NeXan87/Test-Bench/README.md

# Тестовый стенд для двигателей и клапанов на Arduino Nano




Универсальный тестовый стенд для проверки реле, двигателей, воздушных клапанов и другого промышленного оборудования с поддержкой ручного и автоматического режимов работы.

💾 Скачать [Руководство по эксплуатации](https://github.com/NeXan87/Test-Bench/blob/main/Manual.docx?raw=true)!<br/>
📷 Открыть [галерею с фото](https://github.com/NeXan87/Test-Bench/tree/main/Gallery).

## 🔧 Основные возможности

- **4 канала управления реле** (2 группы по 2 реле 24В и 2 пускателей 380В)
- **5 режимов работы**:
  - Ручной с взаимной блокировкой (переключатель реле)
  - Ручной независимый (реле управляются одновременно)
  - Испытание двигателя с тормозом (одновременное включение реле 24В и пускателя 380В)
  - Автоматический синхронный цикл
  - Автоматический асинхронный цикл
- **Гибкая настройка времён**:
  - Время включения реле: 1–60 сек
  - Задержка между циклами: 0–60 сек (с ограничениями по группам)
  - Количество циклов: 1–1000 или бесконечно
- **Защита и безопасность**:
  - Блокировка недопустимых комбинаций
  - Защита от одновременного включения в ручных режимах
  - Автоматическая остановка по завершению циклов
- **Расширенная индикация**:
  - 4 светодиода состояния
  - LCD 2004 дисплей с I2C интерфейсом
  - Отображение постоянного тока нагрузки
- **Удобное управление**:
  - 3 кнопки: Пуск 1, Пуск 2, Стоп
  - 2 переключателя для выбора режима и группы
- **Режимы калибровки и диагностики**:
  - Предназначены для тонкой настройки стенда

## 📐 Схема подключения

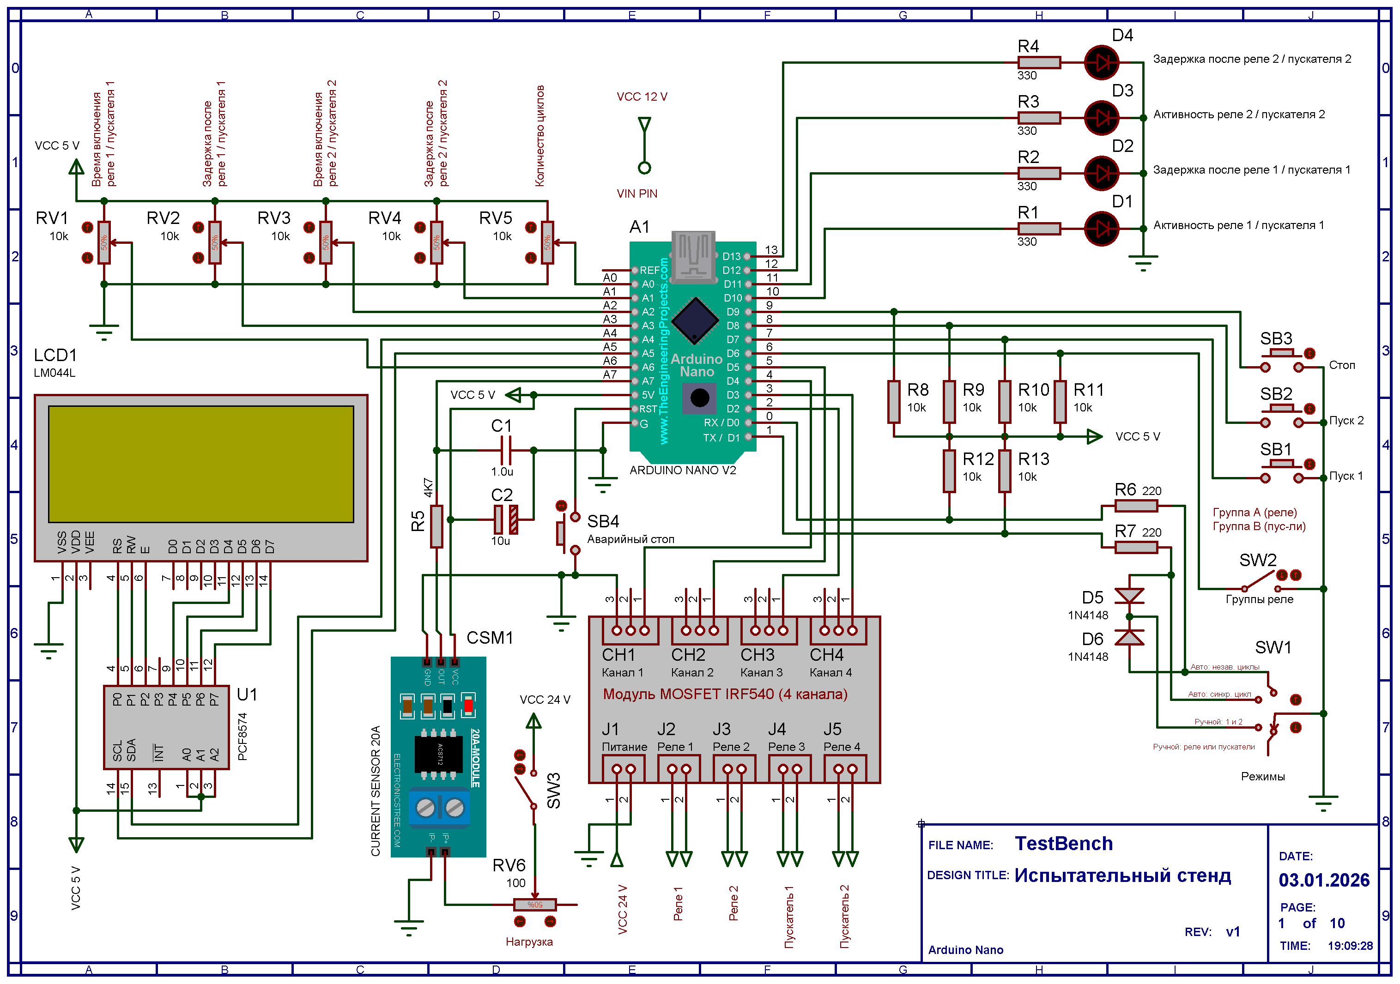
[picture p1: Electric Diagram/TestBench.png]
Принципиальная схема испытательного стенда на Arduino Nano


### Цифровые пины

| Пин | Компонент |
| --- | --- |
| D5  | Реле 24В 2 |
| D4  | Реле 24В 1 |
| D2  | Пускатель 380В 1 |
| D3  | Пускатель 380В 2 |
| D1  | Переключатель MODE0 |
| D0  | Переключатель MODE1 |
| D6  | Переключатель GROUP |
| D7  | Кнопка "Пуск 1" |
| D8  | Кнопка "Пуск 2" |
| D9  | Кнопка "Стоп" |
| D10 | Светодиод состояния реле 1 / пускателя 1 |
| D11 | Светодиод задержки после реле 1 / пускателя 1 |
| D12 | Светодиод состояния реле 2 / пускателя 2 |
| D13 | Светодиод задержки после реле 2 / пускателя 2 |

### Аналоговые пины

| Пин | Компонент |
| --- | --- |
| A0  | Потенциометр "Количество циклов" |
| A1  | Потенциометр "Задержка после реле 2 / пускателя 2" |
| A2  | Потенциометр "Время реле 2 / пускателя 2" |
| A3  | Потенциометр "Задержка после реле 1 / пускателя 1" |
| A6  | Потенциометр "Время реле 1 / пускателя 1" |
| A7  | Датчик тока ACS712 20A |

### I2C дисплей

| Дисплей | Arduino Nano |
| --- | --- |
| VCC | 5V |
| GND | GND |
| SDA | A4 |
| SCL | A5 |

## ⚙️ Режимы работы

### Выбор режима (переключатель D0/D1)

| D0 | D1 | Режим |
| ---- | ---- | --- |
| LOW  | LOW  | Ручной с взаимной блокировкой |
| HIGH | HIGH | Ручной независимый |
| HIGH | LOW  | Автоматический синхронный |
| LOW  | HIGH | Автоматический асинхронный |

### Выбор группы (переключатель D6)

- **LOW**: Группа A (реле 1=D4, реле 2=D5)
- **HIGH**: Группа B (пускатель 1=D2, пускатель 2=D3)

### Особенности режимов

- **Режим 1**: Взаимная блокировка реле (как реверсивный пускатель)
- **Режим 2**: Независимое управление реле, возможна одновременная работа
- **Режим 2, группа B**: Одновременное включение реле 24В и пускателя 380В для испытания эл. двигателя с тормозом
- **Режим 3**: Синхронный цикл: реле1 → задержка → реле2 → задержка → повтор
- **Режим 4**: Асинхронные циклы: каждое реле работает независимо по своим таймерам

### Ограничения

- Режим 4 **заблокирован для группы B** (мигание всех светодиодов)
- Для группы B минимальная задержка = 1 секунда
- Ограничение по превышению тока с выключением реле

## ⚙️ Конфигурационные константы

Все настройки проекта вынесены в файл `config.h` для удобства адаптации под различные требования.

### Пины подключения

| Константа | Значение по умолчанию | Описание |
| --- | --- | --- |
| `RELAY1_24V_PIN`, `RELAY2_24V_PIN`, `RELAY3_380V_PIN`, `RELAY4_380V_PIN` | `4, 5, 2, 3` | Пины управления реле и пускателей |
| `MODE0_SWITCH_PIN`, `MODE1_SWITCH_PIN` | `1, 0` | Пины переключателей режимов |
| `GROUP_SWITCH_PIN` | `6` | Пин переключателя группы |
| `START1_BUTTON_PIN`, `START2_BUTTON_PIN`, `STOP_BUTTON_PIN` | `7, 8, 9` | Пины кнопок управления |
| `LED_ON1_PIN`, `LED2_DELAY1_PIN`, `LED_ON2_PIN`, `LED4_DELAY2_PIN` | `10, 11, 12, 13` | Пины светодиодов индикации |
| `POT_ON1_PIN`, `POT_DELAY1_PIN`, `POT_ON2_PIN`, `POT_DELAY2_PIN`, `POT_CYCLES_PIN` | `A6, A3, A2, A1, A0`  | Аналоговые пины потенциометров |
| `CURRENT_SENSOR_PIN` | `A7` | Пин датчика тока (опционально) |
| `I2C_ADDR` | `0x27` | Адрес I2C дисплея |

### Временные параметры

| Константа | Значение по умолчанию | Описание |
| --- | --- | --- |
| `MIN_ON_RELAY1_TIME` | `1` | Минимальное время работы реле 1 (с) |
| `MAX_ON_RELAY1_TIME` | `60` | Максимальное время работы реле 1 (с) |
| `MIN_ON_RELAY2_TIME_SYNC`  | `0` | Минимальное время работы реле 2 в режиме Авто (3): синхронный (с) |
| `MIN_ON_RELAY2_TIME_ASYNC` | `1` | Минимальное время работы реле 2 в режиме Авто (4): асинхронный (с) |
| `MAX_ON_RELAY2_TIME` | `60` | Максимальное время работы реле 2 (с) |
| `MIN_DELAY_TIME_GROUP_A` | `0` | Минимальная задержка для группы A (с) |
| `MIN_DELAY_TIME_GROUP_B` | `1` | Минимальная задержка для группы для группы B и режима 4 (с) |
| `MAX_DELAY_TIME` | `60` | Максимальная задержка после реле и пускателей(с) |
| `DISPLAY_UPDATE_INTERVAL`  | `200` | Интервал обновления дисплея (мс) |
| `BLINK_LED_INTERVAL` | `500` | Интервал мигания при блокировке (мс) |
| `BRAKE_LED_INTERVAL` | `500` | Частота мигания светодиода в ожидании появления тока (мс) |
| `STARTUP_TIMEOUT` | `1500` | Длительность заставки при включении (мс) |
| `CURRENT_UPDATE_INTERVAL`  | `100` | Частота опроса датчика тока (мс) |
| `POT_UPDATE_INTERVAL` | `150` | Частота опроса потенциометров (мс) |
| `SHOW_SAVE_CALIB_TIMEOUT`  | `1500` | Время отображения сообщения о успешном сохранении данных калибровки потенциометров (мс) |
| `SHOW_ERROR_CALIB_TIMEOUT` | `2000` | Время отображения сообщения о ошибке позиции при калибровки потенциометров (мс) |

### Параметры циклов

| Константа | Значение по умолчанию | Описание |
| --- | --- | --- |
| `MIN_CYCLES` | `1` | Минимальное количество циклов |
| `MAX_CYCLES` | `1000` | Максимальное количество циклов |
| `MAX_CYCLE_COUNT` | `9999` | Максимум посчитанных циклов (далее не будет считать) |
| `INFINITY_THRESHOLD` | `1000` | Порог значения ADC для бесконечного режима |
| `CYCLE_CURVE_POWER`  | `1.5f` | > 1 — "ускоренная" шкала (больше значений в правой части) |
| `STEP1_MAX` | `10` | Границы ступеней: до 10 → шаг STEP1_SIZE |
| `STEP2_MAX` | `100` | Границы ступеней: 11–100 → шаг STEP2_SIZE |
| `STEP3_MAX` | `500` | Границы ступеней: 101–500 → шаг STEP3_SIZE |
| `STEP4_MAX` | `999` | Границы ступеней: 501–999 → шаг STEP4_SIZE |
| `STEP1_SIZE` | `1` | Шаг для изменения количества циклов потенциометром |
| `STEP2_SIZE` | `5` | Шаг для изменения количества циклов потенциометром |
| `STEP3_SIZE` | `10` | Шаг для изменения количества циклов потенциометром |
| `STEP4_SIZE` | `50` | Шаг для изменения количества циклов потенциометром |

### Потенциометры

| Константа | Значение по умолчанию | Описание |
| --- | --- | --- |
| `POT_ALPHA` | `0.3f` | Коэффициент обновления значений потенциометров. Чем меньше значение, тем быстрее |
| `POT_MIN_CALIB` | `200` | Минимальное значение АЦП при калибровке минимального положения потенциометров |
| `POT_MAX_CALIB` | `800` | Максимальное значение АЦП при калибровке минимального положения потенциометров |

### Датчик тока

| Константа | Значение по умолчанию | Описание |
| --- | --- | --- |
| `M_VPER_AMPERE` | `100.0f` | Коэффициент для ACS712-20A (измените для других моделей) |
| `OVERLOAD_CURRENT_LIMIT` | `5.1f` | Порог срабатывания защиты по превышению тока (А) |
| `OVERLOAD_TIME` | `3000` | Время удержания после превышения OVERLOAD_CURRENT_LIMIT (мс) |
| `CURRENT_SAMPLES` | `16` | Количество выборок для усреднения функции mA_DC(). Чем больше число, тем плавнее показания, но медленнее отклик. |
| `CURRENT_ALPHA` | `0.2f` | Коэффициент сглаживания EMA фильтра (экспоненциальное скользящее среднее). 0.0 — полностью сглажено (нет реакции), 1.0 — мгновенная реакция (без фильтра) |
| `VOLTAGE_ACS712` | `4.96f` | Напряжение питания датчика для расчёта напряжения на выходе (В) |

### Адреса минимальных и максимальных значений потенциометров в EEPROM (10 байт: uint16_t)

| Константа | Значение по умолчанию |
| --- | --- |
| `ADDR_ON1_MIN` | `0` |
| `ADDR_ON1_MAX` | `2` |
| `ADDR_D1_MIN` | `4` |
| `ADDR_D1_MAX` | `6` |
| `ADDR_ON2_MIN` | `8` |
| `ADDR_ON2_MAX` | `10` |
| `ADDR_D2_MIN` | `12` |
| `ADDR_D2_MAX` | `14` |
| `ADDR_CYCLES_MIN` | `16` |
| `ADDR_CYCLES_MAX` | `18` |

> 💡 **Совет**: Для адаптации под другое оборудование достаточно изменить значения в `config.h` без правки основного кода.

## 🖥️ Индикация на дисплее

```
R1→10s  D1→05s  M→3
R2→08s  D2→03s  G→A
C→0000/INF    I→0.0A
T→00:00:00      WORK
```

- **R1/R2**: Время включения реле 1/2 или пускателей 1/2
- **D1/D2**: Задержка после реле 1/2 или пускателей 1/2
- **M**: Номер режима (1-4)
- **G**: Выбранная группа (A - реле 24V / B - реверсивные пускатели 380V)
- **C**: Текущий/всего циклов (∞ = бесконечно)
- **I**: Постоянный ток нагрузки в амперах
- **T**: Текущее время цикла
- **Статусы**: STOP / OVERLOAD / FINISH / LOCKED / PAUSED / WT BRAKE / WT MOTOR / ER BRAKE / WORK / READY

## 📦 Требования

### Аппаратные

- Arduino Nano (ATmega328P)
- LCD 2004 с I2C модулем
- 4-х канальный модуль MOSFET IRF540
- Потенциометры 10 кОм (5 шт)
- Тактовые кнопки (3 шт)
- Тумблеры/переключатели (2 шт)
- Светодиоды с резисторами 330 Ом (4 шт)
- Резисторы 220 Ом (2 шт)
- Датчик тока ACS712 20A

## 🛡️ Рекомендации по помехоустойчивости (промышленная эксплуатация)

Если ваше устройство работает рядом с **пускателями, двигателями 380 В или индуктивными нагрузками**, следуйте этим правилам. Иначе — **будете ловить глюки, зависания и сбои**.

### 🔌 1. Разделяйте силовые и сигнальные цепи
- **Никогда не прокладывайте 380 В и 24 В/5 В в одной косе**.
- Минимальное расстояние: **20 см** или **перпендикулярное пересечение**.
- Используйте **отдельные кабели**: силовой — в одной гофре, управляющий — в другой (экранированный).

### 🛡️ 2. Экранируйте — но правильно
- Экран управляющего кабеля **заземляйте ТОЛЬКО в одной точке**.
- Если **GND Arduino изолирован** — **не соединяйте экран с PE**!
  - Вместо этого: **экран → GND Arduino** или **экран → никуда**.
- Используйте **витую пару** для всех сигнальных линий.

### ⚡ 3. Гасите выбросы на источнике
- **На катушках пускателей** ставьте **RC-снабберы** (0.47 мкФ X2 + 220 Ом, 2 Вт).
- **На силовых контактах** — **дополнительные снабберы**, если есть дуга.
- **Диоды Шоттки (1N5819) или 1N4007** — параллельно катушке (катод к +24 В).

### 🔋 4. Питание — ваша первая линия обороны
- Питание Arduino — **только от изолированного источника** (трансформатор + стабилизатор).
- На входе 5 В — **LC-фильтр**: 10 мкГн + 470 мкФ + 100 нФ.
- **Не соединяйте GND Arduino с PE напрямую**.
  - Вместо этого: **GND ↔ PE через Y1-конденсатор 2.2 нФ (250/500 В AC)**.

### 📡 5. Защищайте все внешние пины
- **На каждый сигнал, выходящий из экрана**:
  - **TVS-диод**: **SMBJ5.0CA** (двунаправленный!).
  - **Конденсатор**: 100 пФ (данные) или 100 нФ (питание).
  - **Резистор**: 220–470 Ом последовательно (I²C).
- **Особое внимание**: I²C, ADC (A7), кнопки (D0–D9).

### 🧪 6. Тестируйте в реальных условиях
- **Глюки без нагрузки** — нормальны (резонанс в петле кабеля).
- **Главное — стабильность при подключённом двигателе**.
- Если работает с нагрузкой — **всё в порядке**.

> 💡 **Помехи неизбежны. Но их можно контролировать.**  
> Эти меры проверены в реальной эксплуатации с двигателями, пускателями и 380 В сетью.

### Программные

- Arduino IDE 1.8.0+
- Библиотеки:
  - [Bounce2](https://github.com/thomasfredericks/Bounce2)
  - [ACS712](https://github.com/RobTillaart/ACS712)
  - [LiquidCrystal I2C](https://github.com/johnrickman/LiquidCrystal_I2C)

## 🚀 Установка

1. Склонируйте репозиторий:
   `git clone https://github.com/NeXan87/Test-Bench`

2. Установите необходимые библиотеки через Arduino IDE:

- Скетч → Подключить библиотеку → Управление библиотеками
- Найдите и установите Bounce2, ACS712 и LiquidCrystal I2C

3. Отключите внешнее питание и переведите стенд в 1-й режим
4. Откройте папку проекта в Arduino IDE и загрузите скетч
5. Настройте параметры в файле config.h под ваше оборудование

## 📂 Структура проекта

```
TestBench/
├── TestBench.ino          # Точка входа
├── config.h               # Конфигурация пинов и параметров
├── app_state.h/cpp        # Управление состоянием системы
├── modes.h/cpp            # Логика режимов работы
├── relays.h/cpp           # Управление реле
├── ui.h/cpp               # Кнопки и светодиоды
├── display.h/cpp          # Работа с LCD дисплеем
├── utils.h/cpp            # Вспомогательные функции
└── current.h/cpp          # Измерение тока (опционально)
```

## 📝 Лицензия

Этот проект распространяется под лицензией MIT. Подробности см. в файле LICENSE .

## 🤝 Автор

Разработан для промышленного применения с возможностью расширения функционала.
