NeXan87/Test-Bench/Electric Diagram/4-chan-irf540_scheme.png

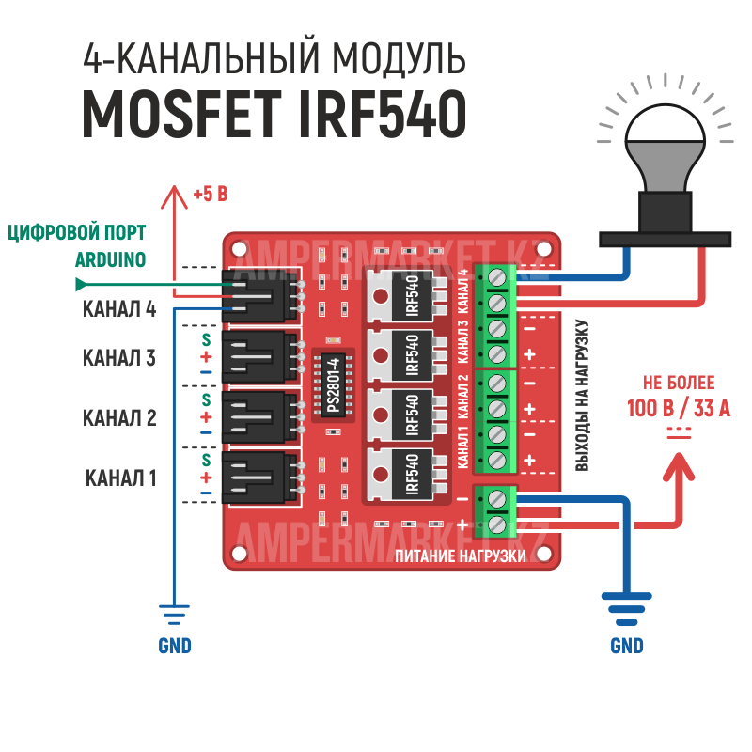
Electric Diagram/4-chan-irf540_scheme.png
