NeXan87/Test-Bench/Gallery/IMG_20251124_162821.jpg

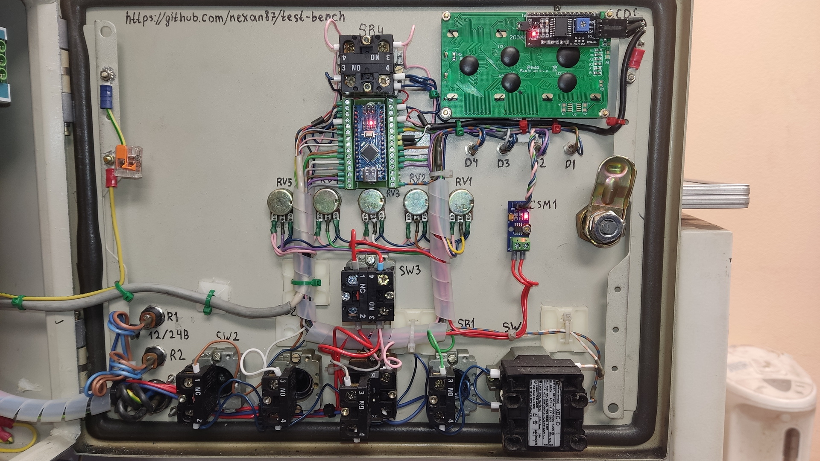
Gallery/IMG_20251124_162821.jpg
