NeXan87/Test-Bench/Gallery/IMG_20251124_162835.jpg

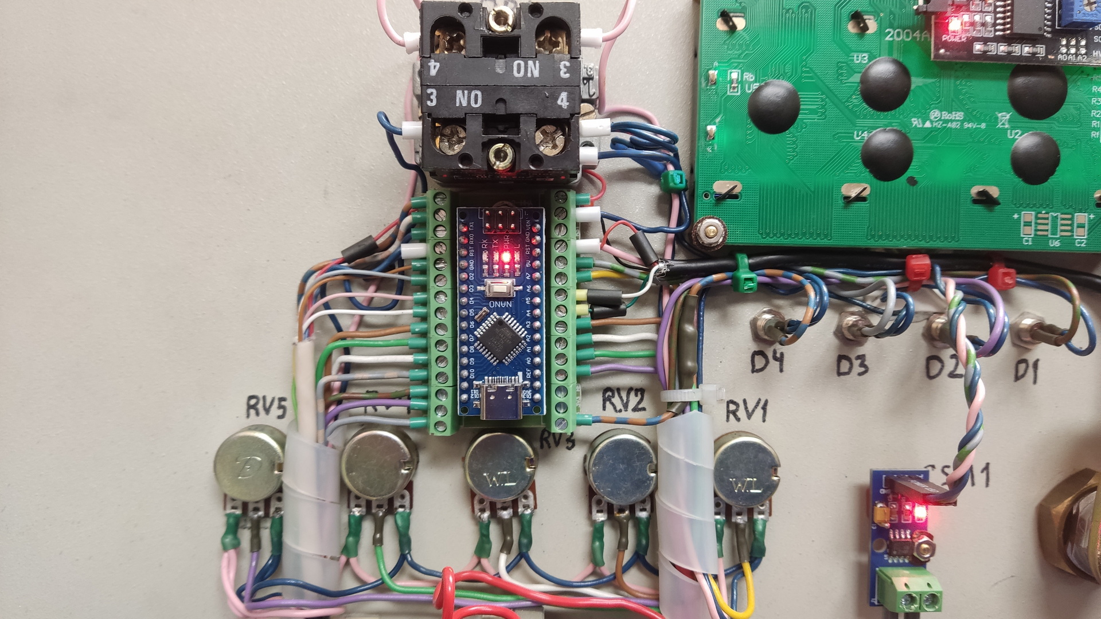
Gallery/IMG_20251124_162835.jpg
