NeXan87/Test-Bench/Gallery/IMG_20251124_162856.jpg

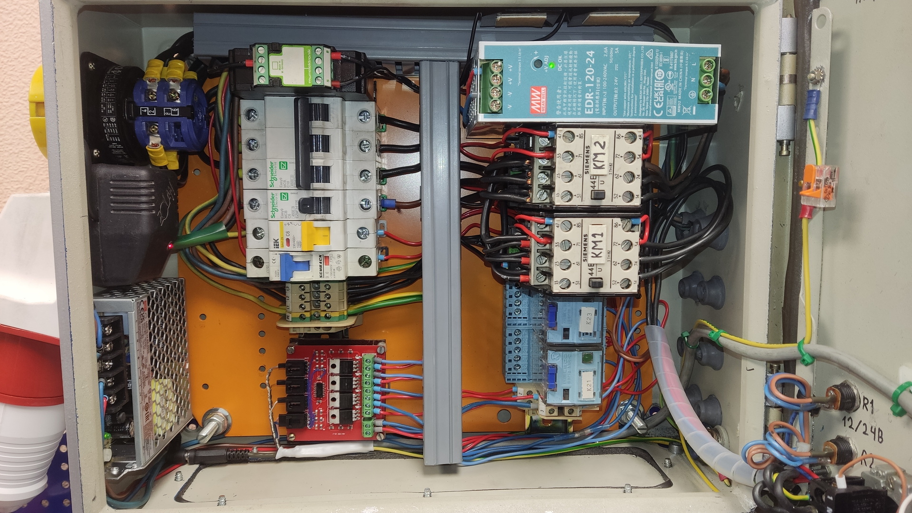
Gallery/IMG_20251124_162856.jpg
