NeXan87/Test-Bench/Gallery/IMG_20251124_163033.jpg

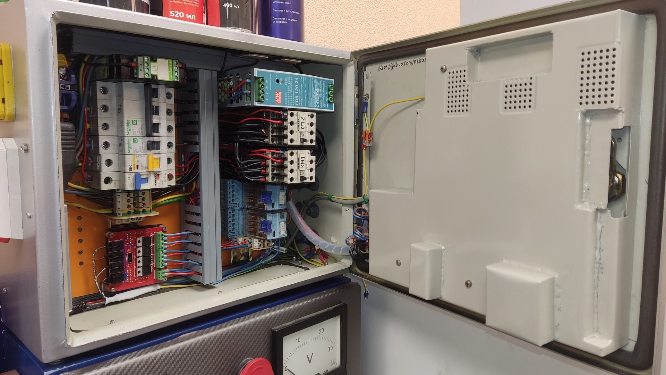
Gallery/IMG_20251124_163033.jpg
