NeXan87/Test-Bench/Gallery/IMG_20251125_162556.jpg

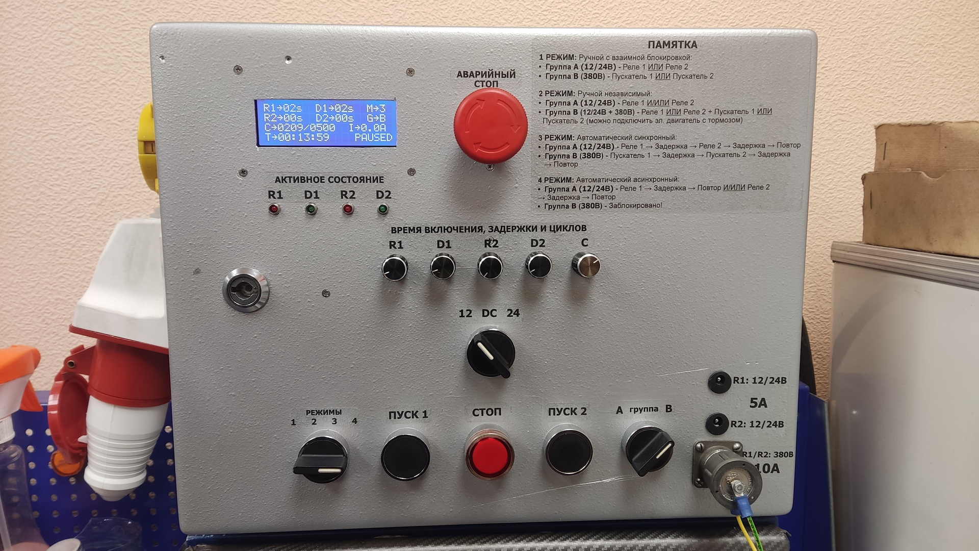
Gallery/IMG_20251125_162556.jpg
