NeXan87/Test-Bench/Gallery/IMG_20251125_162606.jpg

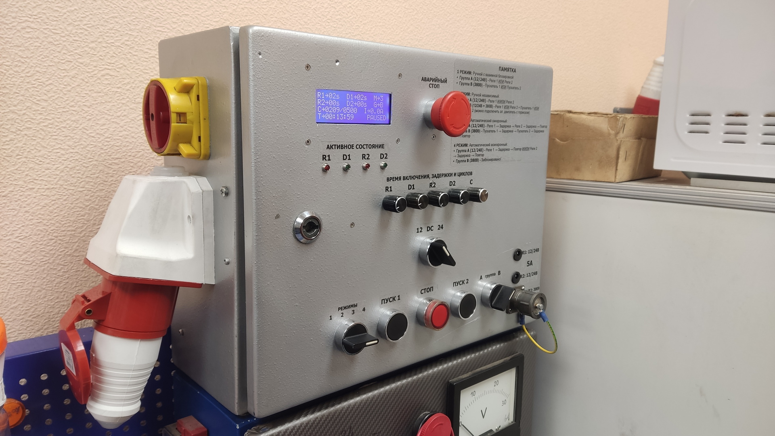
Gallery/IMG_20251125_162606.jpg
