NeXan87/Test-Bench/Gallery/IMG_20260103_183621.jpg

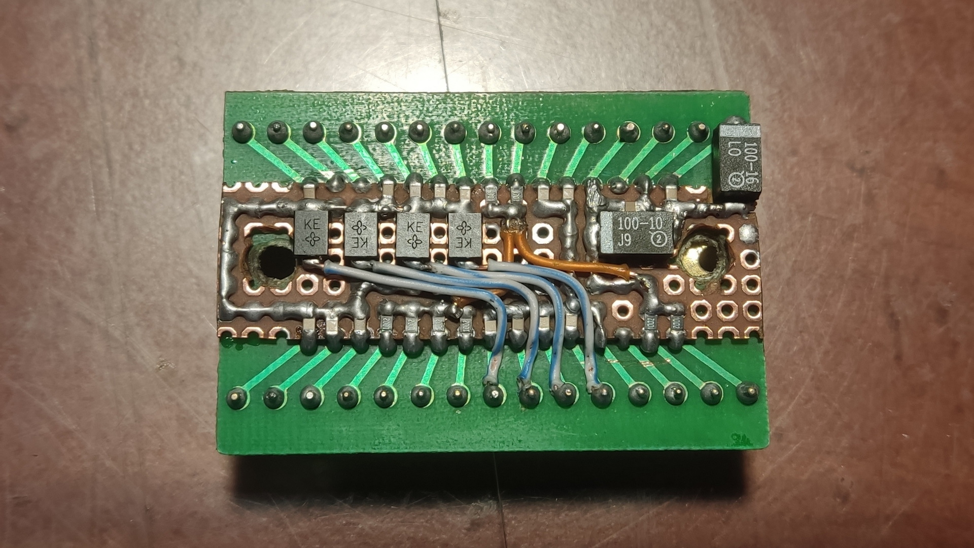
Gallery/IMG_20260103_183621.jpg
