NeXan87/Test-Bench/Manual.docx

Руководство по эксплуатации

Тестовый стенд для двигателей и клапанов на Arduino Nano

1. НАЗНАЧЕНИЕ УСТРОЙСТВА

Универсальный тестовый стенд предназначен для проверки и отладки промышленного оборудования:

- электромагнитной аппаратуры (12В, 24 В, 380 В).
- электродвигателей (включая с тормозом).
- гидравлических и пневматических клапанов.
- других нагрузок с управлением по дискретным сигналам.

Поддерживает ручной и автоматический режимы работы, защиту от перегрузки, индикацию состояния.

2. ТЕХНИЧЕСКИЕ ХАРАКТЕРИСТИКИ

ПАРАМЕТР | ЗНАЧЕНИЕ
Микроконтроллер | Arduino Nano (ATmega328P)
Дисплей | LCD 20×4 I2C (адрес 0x27)
Управление | 3 кнопки + 2 переключателя
Каналы управления | 4 (2 группы по 2 реле)
Входы АЦП | 5 потенциометров + датчик тока
Выходы | 4 реле (MOSFET IRF540)
Индикация | 4 светодиода (LED1–LED4)
Вводное питание | 380 В
Максимальный ток 380 В | 10А
Максимальный ток 12В / 24 В | 5А

3. ОРГАНЫ УПРАВЛЕНИЯ

3.1. Переключатель выбора режимов

№ | РЕЖИМ | ПРИМЕЧАНИЕ
1 | Ручной с взаимной блокировкой | Реле 1 / Пускатель 1 ИЛИ Реле 2 / Пускатель 2
2 | Ручной независимый | Реле 1 / Пускатель 1 И Реле 2 / Пускатель 2
3 | Автоматический синхронный | Реле 1 / Пускатель 1 → Задержка → Реле 2 / Пускатель 2 → Задержка → Повтор
4 | Автоматический асинхронный | Реле 1 / Пускатель 1 → Задержка → Повтор И/ИЛИ Реле 2 / Пускатель 2 → Задержка → Повтор

3.2. Переключатель выбора группы реле

- Группа A — реле 1/2 (2-х канальный выход 12В / 24В).
- Группа B — пускатели 1/2 (1 канальный выход 380В).

💡 Важно! Режим 4 по соображениям безопасности заблокирован для группы B (во избежание включения одновременно 2-х пускателей 380В) — мигают все светодиоды.

3.3. Переключатель выходного напряжения

Этим переключателем можно выставить напряжение на 2-х канальном выходе: 12В или 24В.

3.4. Потенциометры

- Время включения реле 1 или пускателя 1.
- Задержка после выключения реле 1 или пускателя 1.
- Время включения реле 2 или пускателя 2.
- Задержка после выключения реле 2 или пускателя 2.
- Максимальное количество циклов.

💡 Применение. Потенциометры времени работают в автоматических режимах, а потенциометр циклов – в режиме 4.

3.5. Кнопки пуска, останова и аварии

Реле и пускатели запускаются кнопками Пуск 1 и Пуск 2, выключаются кнопкой Стоп. Аварийная кнопка полностью останавливает работу Arduino, все реле и пускатели выключаются, включается сигнальная лампа. После отжатия аварийной кнопки Arduino перезагружается.

4. ДИСПЛЕЙ

4.1. Индикация на дисплее

R1→10s D1→05s M→3 R2→08s D2→03s G→A C→0000/INF I→0.0A T→00:00:00 WORK

1. R1/R2: Время включения Реле 1 / Пускателя 1 или Реле 2 / Пускателя 2
2. D1/D2: Задержка после Реле 1 / Пускателя 1 или Реле 2 / Пускателя 2
3. M: Режим (1–4)
4. G: Группа (A/B)
5. C: Текущий/всего циклов (INF = бесконечно)
6. I: Ток нагрузки (А)
7. T: Общее время цикла
8. Статусы: STOP / OVERLOAD / FINISH / LOCKED / PAUSED / WT BRAKE / WT MOTOR / ER BRAKE / WORK / READY

4.2. Список состояний и их описание:

СТАТУС | ОПИСАНИЕ
STOP | Кнопка «Стоп» нажата. Все реле выключены. Система заблокирована.
OVERLOAD | Перегрузка по току (ток > 5 А в течение 3 секунд). Реле выключены. Требуется сброс кнопкой «Стоп».
FINISH | Цикл завершён (достигнут лимит циклов или включено бесконечное количество). Реле выключены.
LOCKED | Заблокировано: режим 4 при группе B. Мигают все светодиоды.
PAUSED | Пауза в режиме 3 (синхронный авто). Реле выключены. Нажмите Пуск 1 / Пуск 2 для возобновления.
WT BRAKE | Ожидание подключения тормоза двигателя (режим 2, группа B). Реле 1 (24В) включено, мигает светодиод c частотой 1 секунда.
WT MOTOR | Ожидание включения двигателя (режим 2, группа B). Ток тормоза должен быть > 0.3 А. Нажмите Пуск 1 / Пуск 2, чтобы включить пускатель 1/2 (380В).
ER BRAKE | Ошибка тормоза: ток упал ниже 0.3 А во время работы двигателя. Реле выключены.
WORK | Система работает (цикл идёт, реле включены).
READY | Система готова к работе (все реле выключены, нет ошибок).

5. НАСТРОЙКА ВРЕМЕН (режим 3)

5.1. Минимальное время

ГРУППА | РЕЛЕ | МИН. ВРЕМЯ ВКЛЮЧЕНИЯ | МИН. ЗАДЕРЖКА
A | Реле 1 (24В) | 1 секунда | 0 секунд (если Реле 2 >= 1 сек.)
A | Реле 2 (24В) | 0 секунд | 0 секунд
B | Пускатель 1 (380В) | 1 секунда | 1 секунда (если Пускатель 1 = 0 сек.)
B | Пускатель 2 (380В) | 0 секунд | 0 секунд

✅ Для Реле 2 и Пускателя 2 можно выставить 0 секунд — тогда задержка после них будет тоже 0 секунд. Второй канал будет полностью игнорироваться.

- Минимальную задержку после Реле 1 в 0 секунд можно выставить только после установки времени работы Реле 2 более 1 секунды.
- Минимальную задержку в 0 секунд после работы Пускателя 1 можно выставить в случае, если установить минимальное включения Пускателя 2 – 0 секунд. По соображениям безопасности пускатели не могут переключаться вообще без задержки.

6. ПРИНЦИП РАБОТЫ РУЧНЫХ РЕЖИМОВ 1 И 2

6.1. Режим 1 — Ручной с взаимной блокировкой

6.1.1. Логика работы группы A (реле 24В)

  - При нажатии «Пуск 1» — включается реле 1.
  - При нажатии «Пуск 2» — включается реле 2, если реле 1 включено – оно выключается, и наоборот.
  - При нажатии «Стоп» — реле выключается.

6.1.2. Логика работы группы B (пускатели 380В)

  - При нажатии «Пуск 1» — включается пускатель 1.
  - При нажатии «Стоп» — пускатель выключается.
  - При нажатии «Пуск 2» — включается пускатель 2.

⚠️ Важно! Кнопками «Пуск 1» и «Пуск 2» в группе B нельзя переключатель пускатели, только после нажатия кнопки «Стоп».

💡 Применение: В режиме 1 одновременное включение реле и пускателей невозможно. Красные светодиоды показывают состояние реле.

6.2. Режим 2 — Ручной независимый

6.2.1. Логика работы группы A (реле 24В)

  - При нажатии «Пуск1» — включается реле 1.
  - При повторном нажатии «Пуск 1» — выключается реле 1.
  - При нажатии «Пуск2» — включается реле 2.
  - При повторном нажатии «Пуск 2» — выключается реле 2.
  - При нажатии «Стоп» — все реле выключатся.

💡 Применение: Реле 1 и 2 могут быть включены одновременно. Красные светодиоды показывают состояние реле.

6.2.2. Логика работы группы B (управление двигателем с тормозом)

1. Первое нажатие Пуск1/Пуск2 → включается реле 1 или 2 (24В), красный светодиод мигает с частотой в 1 секунду при условии, если тормоз еще не подсоединен к питанию.
  a. Стенд переходит в ожидание подключения тормоза, на дисплее отображается надпись WT BRAKE, означающая ожидание подключение тормоза. По умолчанию минимальный ток, при котором стенд понимает, что тормоз подключен, составляет 0,3А.
  b. После подключения тормоза светодиод начинает мигать в 2 раза чаще, на дисплее надпись меняется на WT MOTOR, означающая, что стенд находится в ожидании включения электродвигателя.
2. Второе нажатие Пуск1/Пуск2 → включается пускатель 1/2 (380В), приводя двигатель во вращение.
  a. Светодиод горит постоянно — двигатель вращается.
  b. Если ток упадёт ниже 0.3А → ошибка, система останавливается, статус ERR BRAKE.

⚠️ Внимание! Перед включением двигателя убедитесь рукой, что он действительно расторможен!

7. ПРИНЦИП РАБОТЫ АВТОМАТИЧЕСКИХ РЕЖИМОВ 3 И 4

7.1. Режим 3 — Автоматический синхронный цикл

Логика работы в группах A и B одинаковая, однако есть некоторые ограничения (описаны под списком).
При нажатии «Пуск1» или «Пуск2» — запускается цикл.

1. Реле 1 / Пускатель 1 включается на время, выставленное потенциометром R1.
2. После окончания R1 — включается задержка D1.
3. После окончания D1 — включается реле 2 на время R2.
4. После окончания R2 — включается задержка D2.
5. После окончания D2 — цикл повторяется N раз (зависит от того, какое количество повторов выставлено потенциометром циклов).
6. Для R2 можно выставить 0 секунд, тогда задержка D2 сбросится до 0 секунд – цикл будет работать Реле 1 / Пускатель 1 → Задержка → Повтор.
7. При достижении лимита циклов — статус FINISH, текущее время на таймере и количество циклов сохраняются и сбрасываются кнопкой «Стоп».

💡 Применение. Для группы A задержки D1 и D2 можно выставить 0 секунд, для группы B – минимум 1 секунда.

7.2. Режим 4 — Автоматический асинхронный цикл

7.2.1. Логика работы для группы A (реле 24В)

1. При нажатии «Пуск 1» — включается реле 1 и начинается его цикл (R1 → D1 → повтор).
2. При нажатии «Пуск 2» — включается реле 2 и начинается его цикл (R2 → D2 → повтор).
3. Оба цикла работают независимо друг от друга.
4. При нажатии «Пуск1» или «Пуск2» — соответствующий цикл останавливается.
5. При нажатии «Стоп» — останавливаются оба цикла.

💡 Применение: В режиме 4 потенциометр циклов и таймер не работают. Группа B заблокирована – на дисплее отображается статус LOCKED и все светодиоды мигают.

8. РЕЖИМ ДИАГНОСТИКИ ВХОДОВ

Режим диагностики позволяет проверить состояние используемых цифровых и аналоговых входов контроллера без активации функций управления. Используется для диагностики подключенных датчиков тока, потенциометров, переключателей и кнопок.

Запуск:

3. Удерживайте кнопку Пуск 2.
4. Подайте питание на устройство.
5. На дисплее отобразится надпись DIAGNOSTIC MODE.
6. Отпустите кнопку Пуск 2 — режим активирован.

Отображение:

На экране выводятся реальные значения используемых входов в формате:

D0=0 D8=0 A2=1023 D1=0 D9=0 A3=1023 D6=0 A0=1023 A6=1023 D7=0 A1=1023 A7=512

Dx — состояние цифровых пинов (0 или 1).

A0-A6 — значения АЦП (0–1023) для потенциометров.

A7 — значения АЦП (0–1023) для датчика тока (должно быть около 512).

Особенности:

- Все функции управления заблокированы.
- Реле, светодиоды и выходы не активируются.
- Для выхода — перезагрузите устройство.

9. РЕЖИМ КАЛИБРОВКИ ПОТЕНЦИОМЕТРОВ

Режим калибровки позволяет настроить точные нулевые и максимальные точки для всех потенциометров, компенсируя их индивидуальные отклонения. После калибровки значения отображаются как 0–100% с учётом реального диапазона.

Запуск:

1. Удерживайте кнопку Пуск 1.
2. Подайте питание на устройство.
3. На дисплее отобразится надпись CALIBRATION MODE.
4. Отпустите кнопку Пуск 1.

Процедура:

1. Калибровка минимума:
  - Поверните все потенциометры в крайнее левое положение.
  - Нажмите кнопку Стоп.
  - На экране появится: Calibration SAVED — подождите 1.5 сек.
2. Калибровка максимума:
  - Поверните все потенциометры в крайнее правое положение.
  - Нажмите кнопку Стоп.
  - На экране появится: Calibration DONE → перезагрузите устройство.

⚠️ Важно. Если на экране появляется Pots not in position, повторите процедуру — потенциометры не достигли нужного положения.

💡 Примечание. После перезагрузки калиброванные значения сохраняются в EEPROM и используются автоматически.

11. ТРЕБОВАНИЯ К КОМПЛЕКТАЦИИ

11.1 Аппаратные компоненты

- Arduino Nano (ATmega328P).
- LCD 2004 с I2C модулем.
- 4-канальный модуль MOSFET IRF540.
- Потенциометры 10 кОм (5 шт).
- Тактовые кнопки (3 шт) и аварийная (1 шт).
- Тумблеры/переключатели (2 шт).
- Светодиоды с резисторами 330 Ом (4 шт).
- Датчик тока ACS712-20A.

12. ПРОШИВКА ARDUINO NANO

1. Скачайте и распакуйте файлы с прошивкой в репозитории: https://github.com/NeXan87/Test-Bench.
2. Установите библиотеки через Arduino IDE:
  - Скетч → Подключить библиотеку → Управление библиотеками.
  - Найдите и установите Bounce2, ACS712 и LiquidCrystal_I2C.
3. Откройте проект в Arduino IDE, выберите COM порт, к которому подключен микроконтроллер, а также тип платы – Arduino Nano.
4. Настройте параметры в файле config.h под ваше оборудование.
5. Отключите внешнее питание и переведите стенд в 1-й режим.
6. Загрузите скетч в микроконтроллер.

13. СХЕМА ПОДКЛЮЧЕНИЯ

13.1. Цифровые пины (D0–D13)

ПИН | КОМПОНЕНТ
D0 | Переключатель MODE1
D1 | Переключатель MODE0
D2 | Пускатель 380В 1
D3 | Пускатель 380В 2
D4 | Реле 24В 1
D5 | Реле 24В 2
D6 | Переключатель GROUP (A, B)
D7 | Кнопка "Пуск 1"
D8 | Кнопка "Пуск 2"
D9 | Кнопка "Стоп"
D10 | Светодиод 1
D11 | Светодиод 2
D12 | Светодиод 3
D13 | Светодиод 4

13.2. Аналоговые пины (A0–A7)

ПИН | КОМПОНЕНТ
A0 | Потенциометр «Количество циклов»
A1 | Потенциометр «Задержка после реле 2 / пускателя 2»
A2 | Потенциометр «Время работы реле 2 / пускателя 2»
A3 | Потенциометр «Задержка после реле 1 / пускателя 1»
A6 | Потенциометр «Время работы реле 1 / пускателя 1»
A7 | Датчик тока

13.3. I2C дисплей

ДИСПЛЕЙ | ARDUINO NANO
VCC | 5V
GND | GND
SDA | A4
SCL | A5
