NeXan87/Test-Bench/Electric Diagram/TestBench.PDF

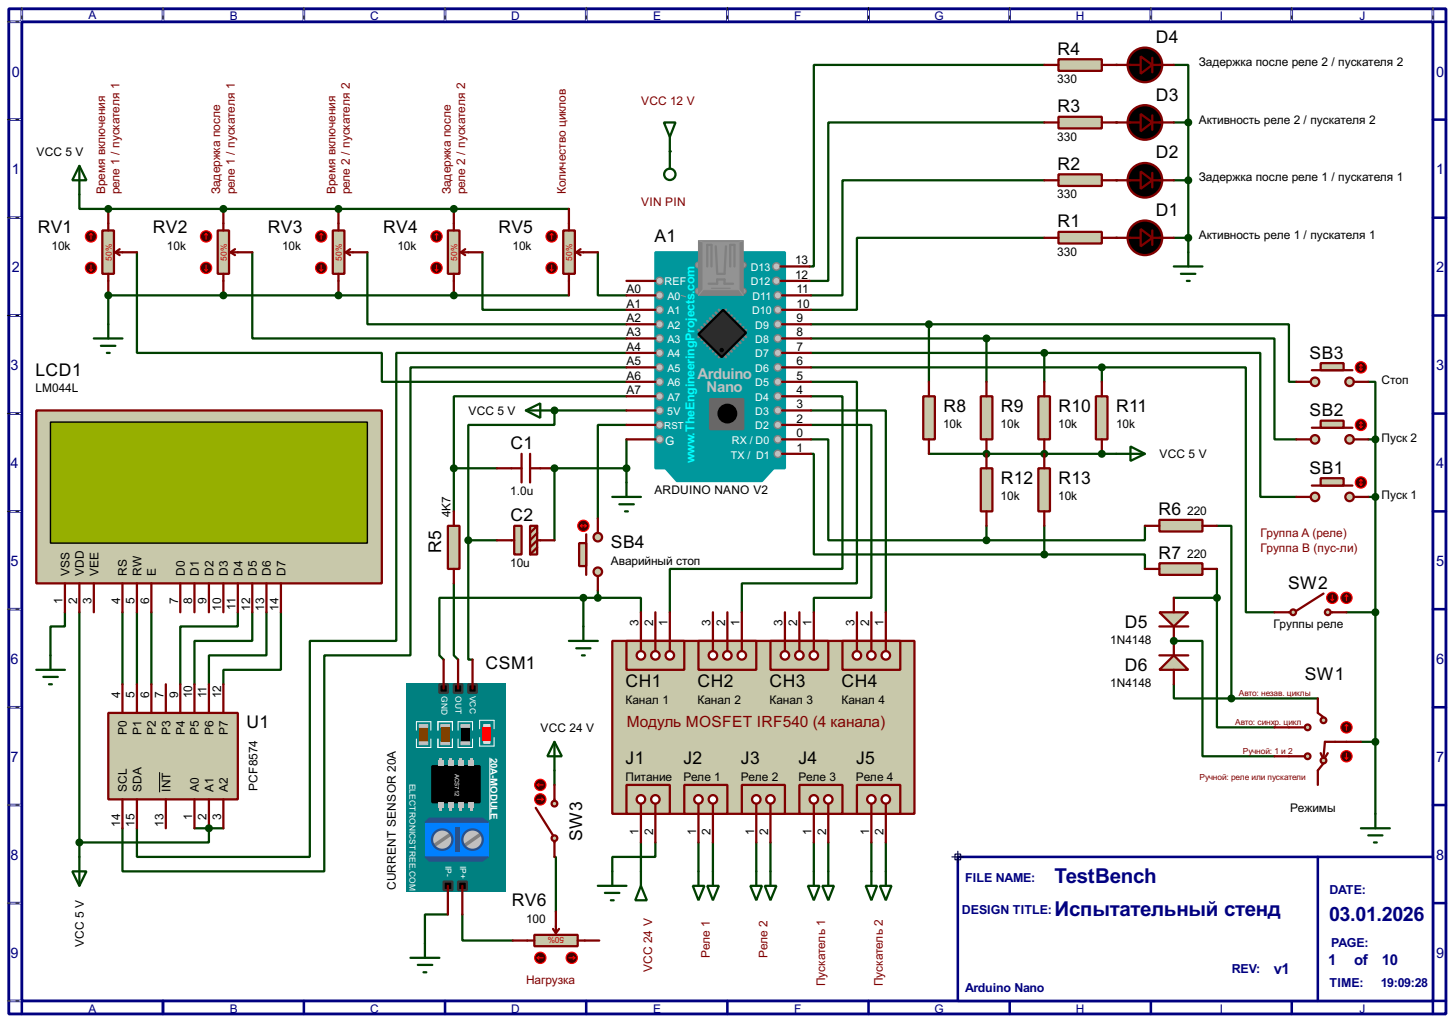
[picture p10: page 1]

Задержка после реле 2 / пускателя 2

Задержка после реле 1 / пускателя 1

Группа A (реле) Группа B (пус-ли)

Канал 1
Канал 4 Модуль MOSFET IRF540 (4 канала)

Ручной: реле или пускатели

DESIGN TITLE:Испытательный стенд
