NeXan87/Test-Bench/(list of files, drawings)

Other design files:
Electric Diagram/Proteus Library/Arduino NANO Library for Proteus V2.0/Arduino NANO Library for Proteus V2.0.DSN
Electric Diagram/TestBench.pdsprj
