NeXan87/Test-Bench/(commit log)

2025-10-03 Первая версия проекта
    [TestBench.pdsprj]
2025-10-03 Добавляет README
2025-10-03 Редактирует README
2025-10-03 Добавляет лицензию
2025-10-03 Пересобирает все файлы
    [TestBench.pdsprj]
2025-10-03 Restore project files with proper line endings and .gitattributes
    [TestBench.pdsprj]
2025-10-03 Выносит константы в config.h
2025-10-03 Настраивает дисплей
2025-10-03 Добавляет ссылку на прошивку проекта
2025-10-03 Добавляет датчик тока в схему
    [TestBench.pdsprj]
2025-10-03 Редактирует схему
    [TestBench.pdsprj]
2025-10-06 Исправляет ошибки
    [TestBench.pdsprj]
2025-10-06 Добавляет библиотеки для Proteus
    [Arduino NANO Library for Proteus V2.0.DSN, TestBench.pdsprj]
2025-10-07 Делает кнопку Стоп аварийной
    [TestBench.pdsprj]
2025-10-10 Исправляет баги
2025-10-14 Меняет местами пины D0, D1 с D4, D5
    [TestBench.pdsprj]
2025-10-14 Оптимизирует utils.cpp
2025-10-14 Оптимизирует display.cpp
2025-10-14 Оптимизирует ui.cpp
2025-10-14 Оптимизирует relays.cpp
2025-10-14 Оптимизирует app_state.cpp
2025-10-14 Оптимизирует modes.cpp
2025-10-14 Изменяет схему
    [TestBench.pdsprj]
2025-10-16 Добавляет пробелы на дисплее
2025-10-16 Правит схему
    [TestBench.pdsprj]
2025-10-16 Блокирует потенциометры в состоянии РАБОТА
2025-10-16 Блокирует потенциометры в состоянии ФИНИШ
2025-10-18 Делает логарифмический потенциометр циклов
2025-10-18 Редактирует расположение значений на дисплее
2025-10-18 Использует формат времени HH:MM:SS вместо MM:SS
2025-10-18 Меняет расположение статусов на дисплее
2025-10-18 Меняет отображение информации на дисплее
2025-10-20 Исправляет работу переключателей в 3 и 4 режимах
    [app_state.cpp, app_state.h, relays.cpp, relays.h]
2025-10-20 Добавляет статус READY
2025-10-20 Добавляет статус LOCKED
2025-10-20 Добавляет статус PAUSED
2025-10-20 Редактирует current.cpp
2025-10-21 Исправляет баг с выводом тока на дисплей
    [config.h, current.cpp, display.cpp]
2025-10-21 Добавляет защиту по току
    [TestBench.pdsprj]
2025-10-21 Меняет порядок вывода статусов на дисплей
2025-10-21 Добавляет режим управления двигателя с тормозом
2025-10-21 Налаживает режим управления двигателя с тормозом
2025-10-30 Исправляет баги и делает улучшения
    [config.h, current.cpp, modes.cpp, modes.h, ui.cpp]
2025-11-01 Изменяет названия переменных пинов реле
2025-11-01 Изменяет названия переменных в config
2025-11-01 Редактирует README.md
2025-11-01 Создает руководство по эксплуатации
2025-11-02 Наполняет руководство по эксплуатации
2025-11-04 Редактирует руководство и электросхему
    [TestBench.pdsprj]
2025-11-04 Экспортирует электросхему
2025-11-04 Редактирует Manual
2025-11-06 Исправляет баг с отображением тока
    [config.h, current.cpp, display.cpp, modes.cpp, modes.h]
2025-11-07 Правит принципиальную схему
    [TestBench.pdsprj]
2025-11-07 Правит коэффициэнты определения тока
2025-11-07 Исправляет баг с задержсками
    [TestBench.pdsprj]
2025-11-07 Исправляет баг с ненужными импульсами на реле, если время 0с
    [modes.cpp]
2025-11-07 Удаляет ненужную задержку в loop()
2025-11-07 Исправляет некорректное объявление посторонних функций в заголовке current.h
    [current.cpp, current.h]
2025-11-07 Исправляет потенциальный выход за пределы буфера в utils_formatTimeSec при значениях ≥ 100 сек
    [utils.cpp]
2025-11-07 Исправляет небезопасный доступ к состоянию кнопок из других модулей
    [ui.h]
2025-11-07 Исправляет отсутствие проверки переполнения счётчика циклов
    [modes.cpp]
2025-11-07 Исправляет отсутствие защиты от деления на ноль в mapFast при некорректных пределах АЦП
    [app_state.cpp]
2025-11-07 Исправляет несогласованность типов в интерфейсе display_update
    [display.cpp, display.h]
2025-11-07 Защищает статический буфер в utils_formatCycleTime
2025-11-07 Исправляет неточность в EMA-фильтре тока при старте
    [current.cpp]
2025-11-07 Исправляет отсутствие проверки диапазона при записи в LED-пины
    [ui.cpp]
2025-11-07 Исправляет светодиод - не переключает частоту мигания при смене статуса тормоза
    [modes.cpp]
2025-11-08 Исправляет баг с миганием светодиода
    [modes.cpp]
2025-11-08 Добавляет режим диагностики
2025-11-08 Оптимизирует режим диагностики
2025-11-10 Оптимизирует вывод диагостических данных на дисплей
2025-11-10 Делает калибровку нуля для отображения тока
2025-11-10 Добавляет калибровку потенциометров
2025-11-10 Перемещает калибровку в отдельные файлы
2025-11-10 Переносит режим диагностики в отдельные файлы
2025-11-10 Редактирует руководство
2025-11-11 Добавляет калибровку максимальных значений потенциометров
2025-11-11 Добавляет файлы диагностики
2025-11-11 Добавляет новые константы
2025-11-11 Дополняет руководство
2025-11-11 Форматирует руководство
2025-11-11 Редактирует принципиальную схему
    [TestBench.pdsprj]
2025-11-11 Редактирует описание и константы
2025-11-11 Редактирует описание
2025-11-11 Добавляет наклейки
2025-11-11 Переименовывает файл наклеек
2025-11-12 Обновляет стикеры
2025-11-12 Обновляет gitignore
2025-11-14 Изменяет значения для расчета тока
2025-11-14 Обновляет эл. схему
    [TestBench.pdsprj]
2025-11-17 Правит мидпоинт датчика тока
2025-11-17 Добавляет RC фильтр на схему
    [TestBench.pdsprj]
2025-11-18 Меняет функцию получения средней точки тока
    [TestBench.pdsprj]
2025-11-21 Исправляет баг с заданием времени
    [app_state.cpp]
2025-11-23 Дополняет памятку
2025-11-23 Делает мелкие исправления
2025-11-26 Добавляет фото стенда
2025-11-26 Удаляет бэкапы фото
2025-11-26 Обновляет README
2026-01-03 Добавляет подтягвающие резисторы на пины
    [TestBench.pdsprj]
2026-01-03 Переносит проект в Platformio
2026-01-03 Обновляет форматирование
    [TestBench.pdsprj]
