NeXan87/Test-Bench/(notices)

Notices in the files:
README.md:
License: MIT
